bjornpo/ESP32_SensorScope/README.md

# ESP32_SensorScope
A protocol analyzer and simulator for serial sensors

## Initializing Submodules
This project uses Git submodules for kicad part library. To clone the repository and initialize submodules:
```bash
git clone --recurse-submodules <repo-url>
