bjornpo/ESP32_SensorScope/hardware/kicad/ESP32_SensorScope/4Inch TFT SPI LCD 480X320.step

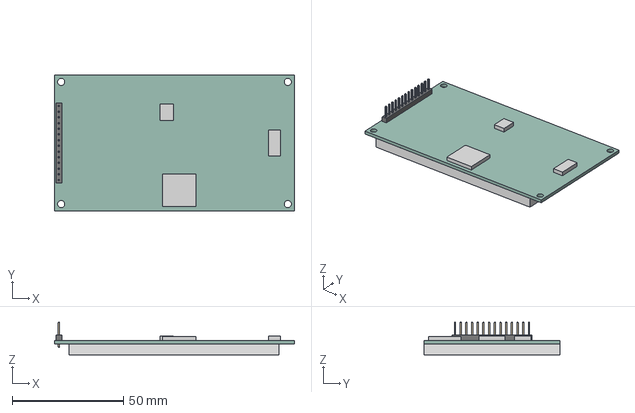
[picture p3: CAD file, 2025-01-19]
hardware/kicad/ESP32_SensorScope/4Inch TFT SPI LCD 480X320.step
108.0 x 61.0 x 14.8 mm
