bjornpo/ESP32_SensorScope/hardware/kicad/ESP32_SensorScope/ESP32-S3-WROOM-1.kicad_sch

## KiCad design hardware/kicad/ESP32_SensorScope/ESP32-S3-WROOM-1.kicad_sch (2025-04-11, an earlier design)

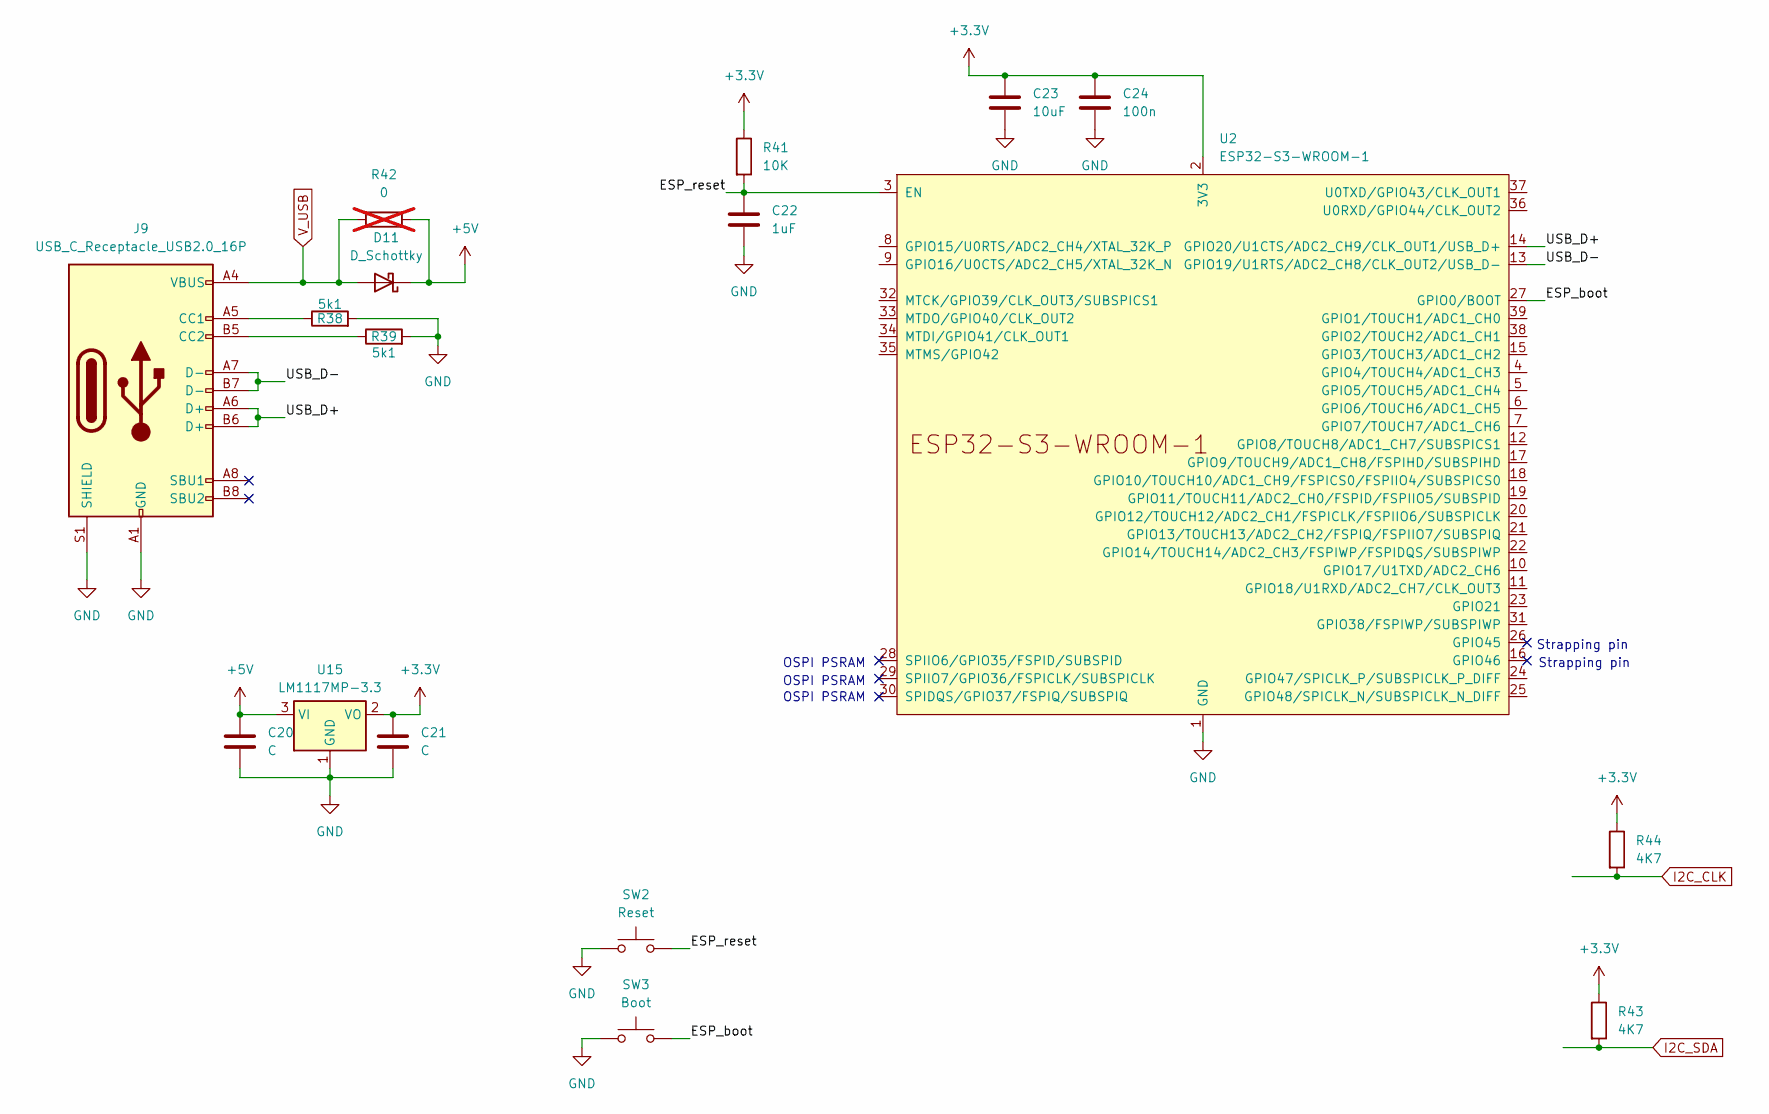
[picture p4: schematic ESP32-S3-WROOM-1.kicad_sch]

Parts:
C20, C21: C
C22: 1uF
C23: 10uF
C24: 100n
D11: D_Schottky
J9: USB_C_Receptacle_USB2.0_16P
R38, R39: 5k1
R41: 10K
R42: 0; not fitted
R43, R44: 4K7
SW2: Reset
SW3: Boot
U2: ESP32-S3-WROOM-1
U15: LM1117MP-3.3; SOT-223-3_TabPin2

Connections:
+3.3V: C21.1, C23.1, C24.1, R41.1, R43.1, R44.1, U2.2 (3V3), U15.2 (VO)
+5V: C20.1, D11.1 (K), R42.2, U15.3 (VI)
ESP_boot: SW3.2, U2.27 (GPIO0/BOOT)
ESP_reset: C22.1, R41.2, SW2.2, U2.3 (EN)
GND: C20.2, C21.2, C22.2, C23.2, C24.2, J9.A1 (GND), J9.A12 (GND), J9.B1 (GND), J9.B12 (GND), J9.S1 (SHIELD), R38.2, R39.2, SW2.1, SW3.1, U2.1 (GND), U2.40 (GND), U2.41 (GND), U15.1 (GND)
I2C_CLK: R44.2
I2C_SDA: R43.2
unnamed: J9.A5 (CC1), R38.1
unnamed: J9.B5 (CC2), R39.1
USB_D+: J9.A6 (D+), J9.B6 (D+), U2.14 (GPIO20/U1CTS/ADC2_CH9/CLK_OUT1/USB_D+)
USB_D-: J9.A7 (D-), J9.B7 (D-), U2.13 (GPIO19/U1RTS/ADC2_CH8/CLK_OUT2/USB_D-)
V_USB: D11.2 (A), J9.A4 (VBUS), J9.A9 (VBUS), J9.B4 (VBUS), J9.B9 (VBUS), R42.1

Notes on the sheet:
Strapping pin
OSPI PSRAM
