bjornpo/ESP32_SensorScope/hardware/kicad/ESP32_SensorScope/Power_management.kicad_sch

## KiCad design hardware/kicad/ESP32_SensorScope/Power_management.kicad_sch (2025-04-11, an earlier design)

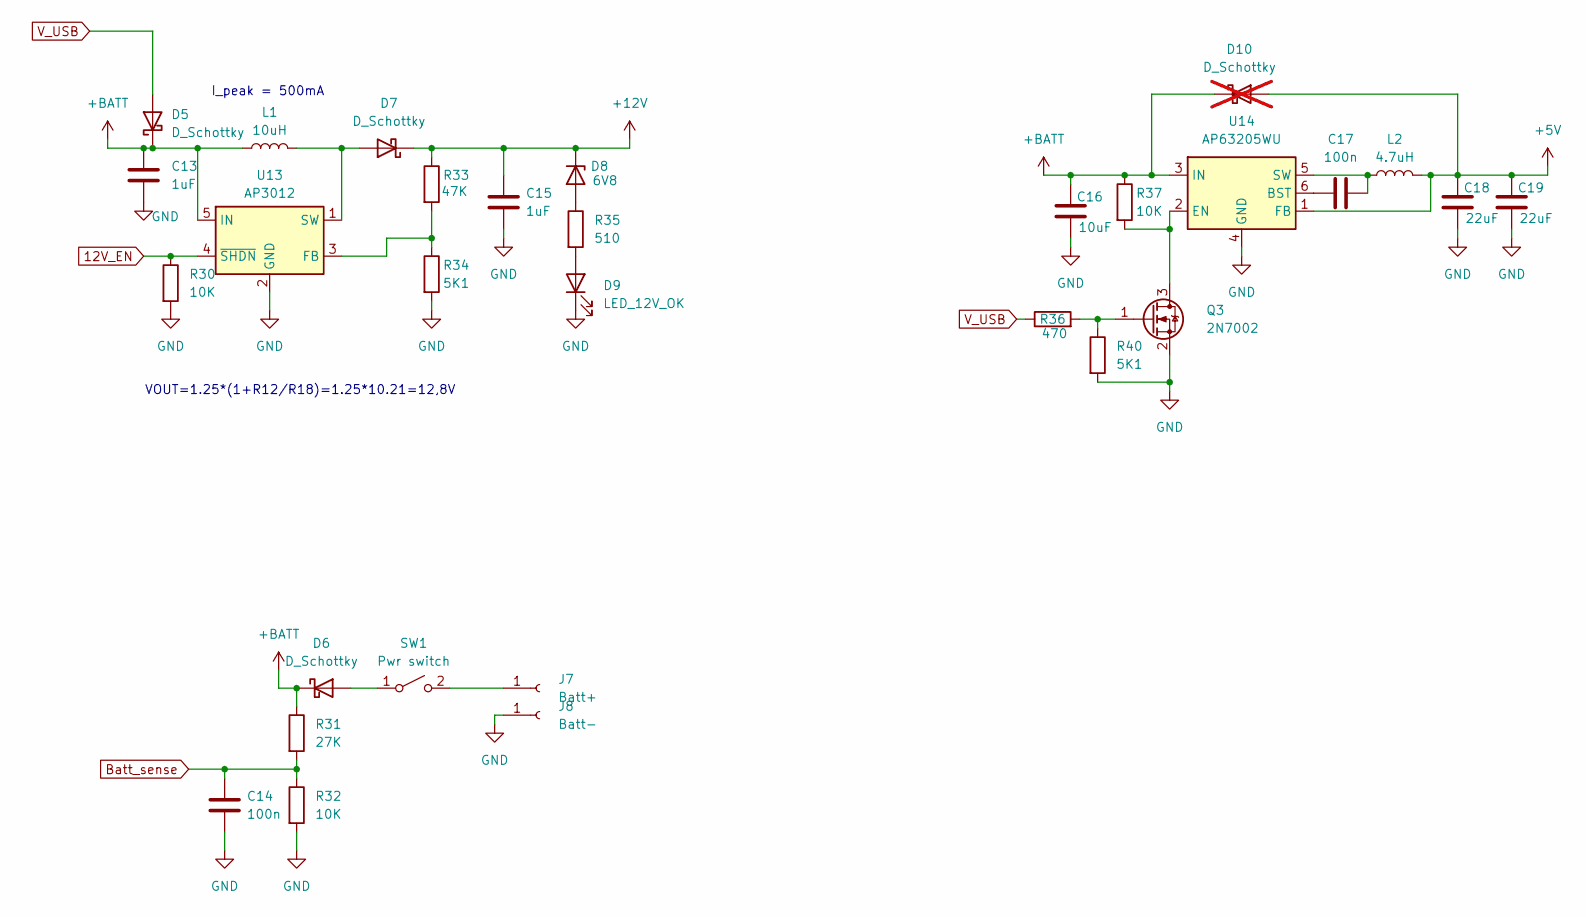
[picture p5: schematic Power_management.kicad_sch]

Parts:
C13, C15: 1uF
C14, C17: 100n
C16: 10uF
C18, C19: 22uF
D5, D6, D7: D_Schottky
D8: 6V8
D9: LED_12V_OK
D10: D_Schottky; not fitted
J7: Batt+
J8: Batt-
L1: 10uH
L2: 4.7uH
Q3: 2N7002; SOT-23
R30, R32, R37: 10K
R31: 27K
R33: 47K
R34, R40: 5K1
R35: 510
R36: 470
SW1: Pwr switch
U13: AP3012; SOT-23-5
U14: AP63205WU; TSOT-23-6

Connections:
12V_EN: R30.1, U13.4 (~SHDN)
+5V: C18.2, C19.2, D10.2 (A), L2.2, U14.1 (FB)
+12V: C15.1, D7.1 (K), D8.1 (K), R33.1
+BATT: C13.1, C16.2, D5.1 (K), D6.1 (K), D10.1 (K), L1.1, R31.1, R37.1, U13.5 (IN), U14.3 (IN)
Batt_sense: C14.1, R31.2, R32.1
GND: C13.2, C14.2, C15.2, C16.1, C18.1, C19.1, D9.1 (K), J8.1, Q3.2 (S), R30.2, R32.2, R34.2, R40.2, U13.2 (GND), U14.4 (GND)
unnamed: C17.1, U14.6 (BST)
unnamed: C17.2, L2.1, U14.5 (SW)
unnamed: D6.2 (A), SW1.1 (A)
unnamed: D7.2 (A), L1.2, U13.1 (SW)
unnamed: D8.2 (A), R35.1
unnamed: D9.2 (A), R35.2
unnamed: J7.1, SW1.2 (B)
unnamed: Q3.1 (G), R36.2, R40.1
unnamed: Q3.3 (D), R37.2, U14.2 (EN)
unnamed: R33.2, R34.1, U13.3 (FB)
V_USB: D5.2 (A), R36.1

Notes on the sheet:
I_peak = 500mA
VOUT=1.25*(1+R12/R18)=1.25*10.21=12,8V
