bjornpo/ESP32_SensorScope/hardware/kicad/ESP32_SensorScope/RS232.kicad_sch

## KiCad design hardware/kicad/ESP32_SensorScope/RS232.kicad_sch (2025-04-11, an earlier design)

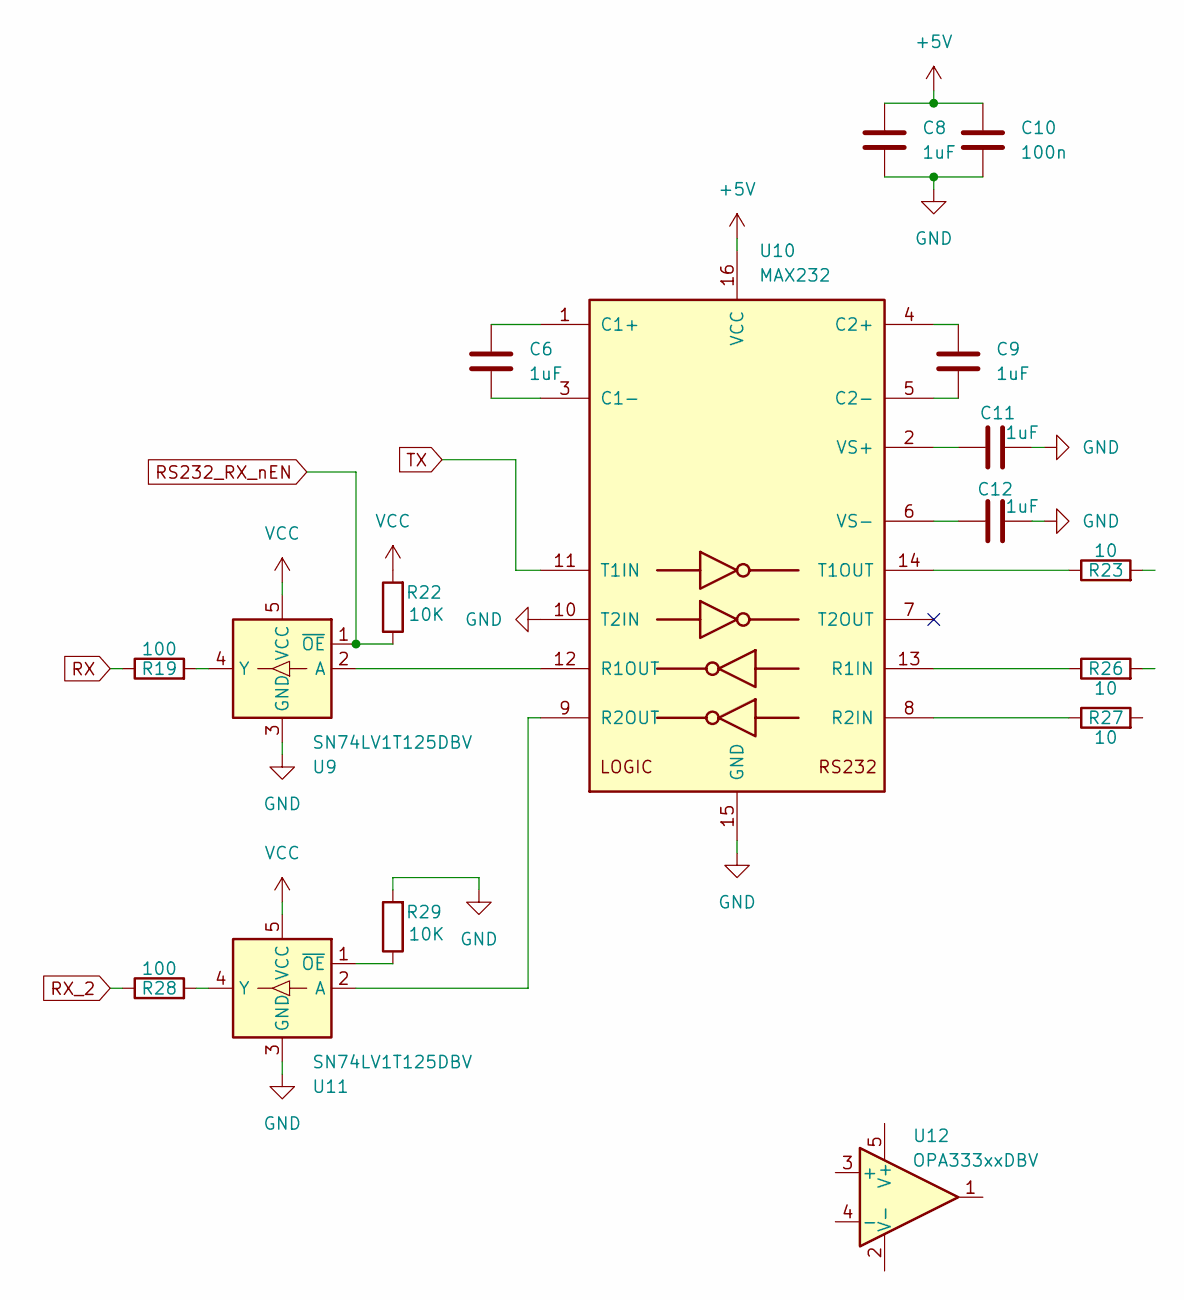
[picture p6: schematic RS232.kicad_sch]

Parts:
C6, C8, C9, C11, C12: 1uF
C10: 100n
R19, R28: 100
R22, R29: 10K
R23, R26, R27: 10
U9, U11: SN74LV1T125DBV; SOT-23-5
U10: MAX232
U12: OPA333xxDBV; SOT-23-5

Connections:
+5V: C8.1, C10.1, U10.16 (VCC)
GND: C8.2, C10.2, C11.1, C12.1, R29.2, U9.3 (GND), U10.10 (T2IN), U10.15 (GND), U11.3 (GND)
unnamed: C6.1, U10.1 (C1+)
unnamed: C6.2, U10.3 (C1-)
unnamed: C9.1, U10.4 (C2+)
unnamed: C9.2, U10.5 (C2-)
unnamed: C11.2, U10.2 (VS+)
unnamed: C12.2, U10.6 (VS-)
unnamed: R19.2, U9.4 (Y)
unnamed: R23.1, U10.14 (T1OUT)
unnamed: R26.1, U10.13 (R1IN)
unnamed: R27.1, U10.8 (R2IN)
unnamed: R28.2, U11.4 (Y)
unnamed: R29.1, U11.1 (~OE)
unnamed: U10.9 (R2OUT), U11.2 (A)
unnamed: U9.2 (A), U10.12 (R1OUT)
RS232_RX_nEN: R22.1, U9.1 (~OE)
RX: R19.1
RX_2: R28.1
TX: U10.11 (T1IN)
VCC: R22.2, U9.5 (VCC), U11.5 (VCC)
