bjornpo/ESP32_SensorScope/hardware/kicad/ESP32_SensorScope/RS485.kicad_sch

## KiCad design hardware/kicad/ESP32_SensorScope/RS485.kicad_sch (2025-04-11, an earlier design)

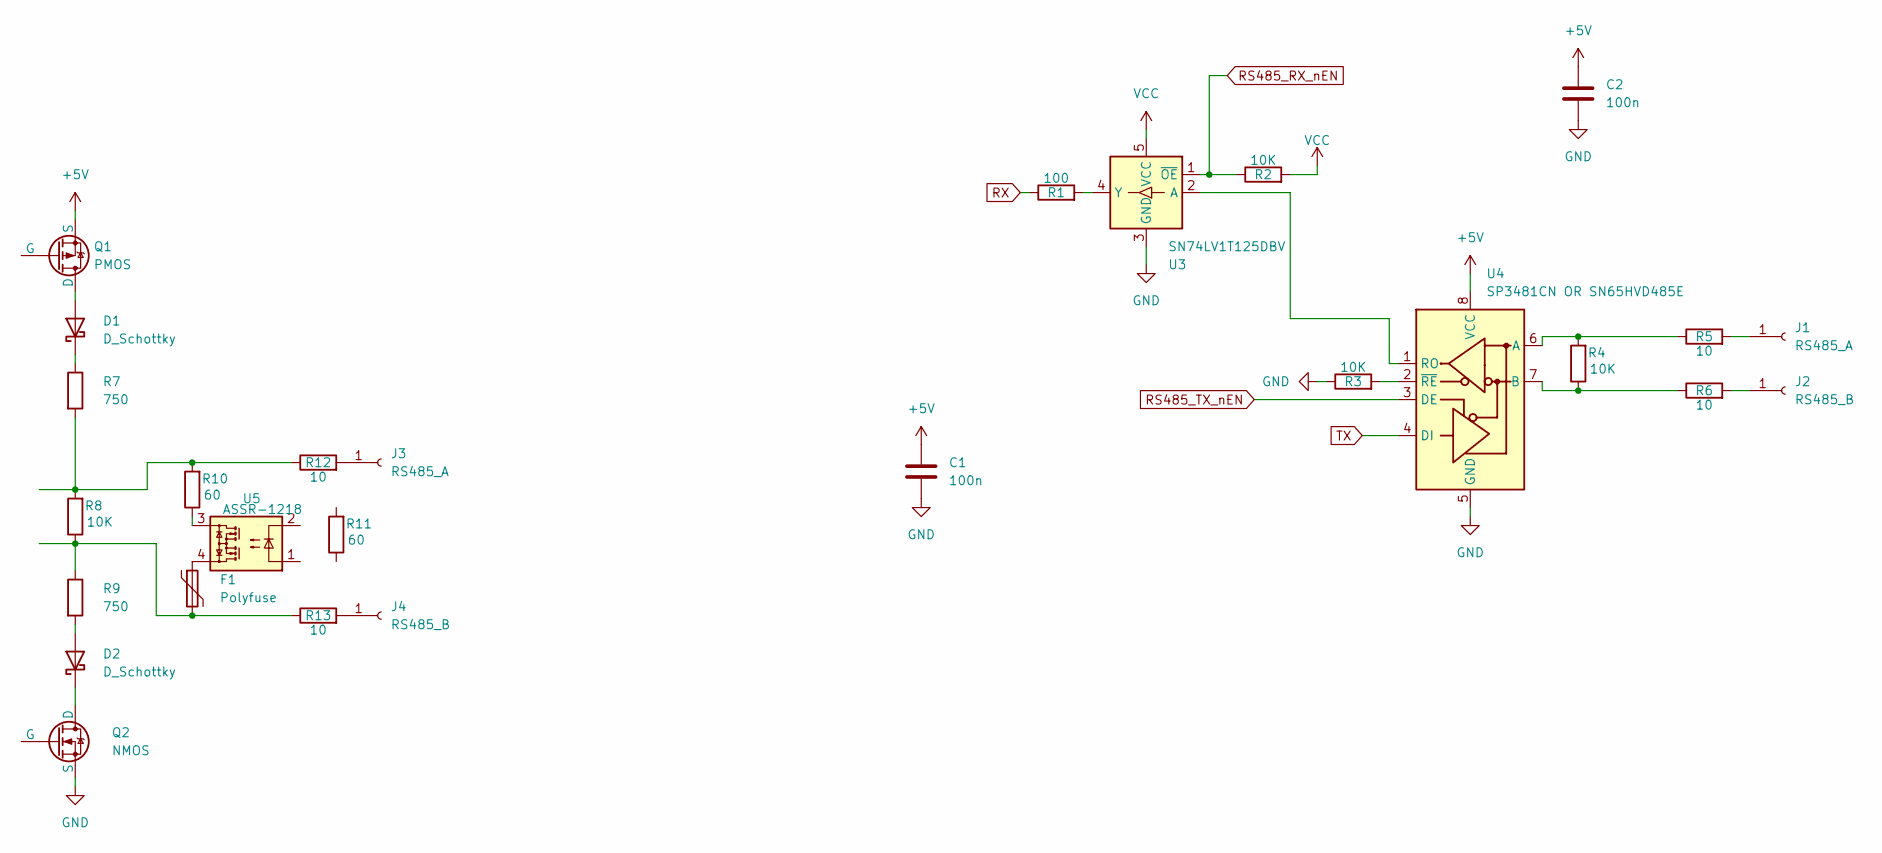
[picture p7: schematic RS485.kicad_sch]

Parts:
C1, C2: 100n
D1, D2: D_Schottky
F1: Polyfuse
J1, J3: RS485_A
J2, J4: RS485_B
Q1: PMOS
Q2: NMOS
R1: 100
R2, R3, R4, R8: 10K
R5, R6, R12, R13: 10
R7, R9: 750
R10, R11: 60
U3: SN74LV1T125DBV; SOT-23-5
U4: SP3481CN OR SN65HVD485E; SOIC-8_3.9x4.9mm_P1.27mm
U5: ASSR-1218; SO-4_4.4x4.3mm_P2.54mm

Connections:
+5V: C1.1, C2.1, Q1.3 (S), U4.8 (VCC)
GND: C1.2, C2.2, Q2.3 (S), R3.1, U3.3 (GND), U4.5 (GND)
unnamed: D1.1 (K), R7.1
unnamed: D1.2 (A), Q1.1 (D)
unnamed: D2.1 (K), Q2.1 (D)
unnamed: D2.2 (A), R9.2
unnamed: F1.1, U5.4
unnamed: F1.2, R8.1, R9.1, R13.1
unnamed: J1.1, R5.2
unnamed: J2.1, R6.2
unnamed: J3.1, R12.2
unnamed: J4.1, R13.2
unnamed: R1.2, U3.4 (Y)
unnamed: R3.2, U4.2 (~RE)
unnamed: R4.1, R6.1, U4.7 (B)
unnamed: R4.2, R5.1, U4.6 (A)
unnamed: R10.1, U5.3
unnamed: R7.2, R8.2, R10.2, R12.1
unnamed: U3.2 (A), U4.1 (RO)
RS485_RX_nEN: R2.1, U3.1 (~OE)
RS485_TX_nEN: U4.3 (DE)
RX: R1.1
TX: U4.4 (DI)
VCC: R2.2, U3.5 (VCC)
