bjornpo/ESP32_SensorScope/hardware/kicad/ESP32_SensorScope/SDI12.kicad_sch

## KiCad design hardware/kicad/ESP32_SensorScope/SDI12.kicad_sch (2025-04-11, an earlier design)

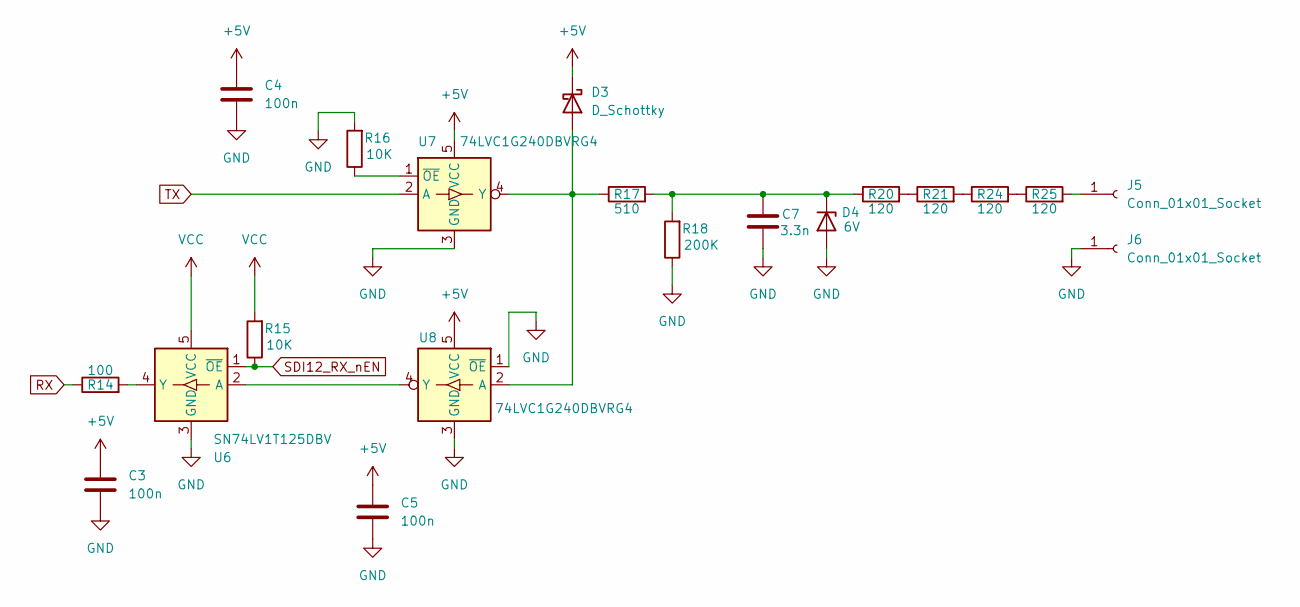
[picture p8: schematic SDI12.kicad_sch]

Parts:
C3, C4, C5: 100n
C7: 3.3n
D3: D_Schottky
D4: 6V
J5, J6: Conn_01x01_Socket
R14: 100
R15, R16: 10K
R17: 510
R18: 200K
R20, R21, R24, R25: 120
U6: SN74LV1T125DBV; SOT-23-5
U7, U8: 74LVC1G240DBVRG4; SOT-23-5

Connections:
+5V: C3.1, C4.1, C5.1, D3.1 (K), U7.5 (VCC), U8.5 (VCC)
GND: C3.2, C4.2, C5.2, C7.2, D4.2 (A), J6.1, R16.2, R18.1, U6.3 (GND), U7.3 (GND), U8.1 (~OE), U8.3 (GND)
unnamed: C7.1, D4.1 (K), R17.2, R18.2, R20.1
unnamed: D3.2 (A), R17.1, U7.4 (Y), U8.2 (A)
unnamed: J5.1, R25.2
unnamed: R14.2, U6.4 (Y)
unnamed: R16.1, U7.1 (~OE)
unnamed: R20.2, R21.1
unnamed: R21.2, R24.1
unnamed: R24.2, R25.1
unnamed: U6.2 (A), U8.4 (Y)
RX: R14.1
SDI12_RX_nEN: R15.1, U6.1 (~OE)
TX: U7.2 (A)
VCC: R15.2, U6.5 (VCC)
