bjornpo/ESP32_SensorScope/hardware/kicad/ESP32_SensorScope/Scope.kicad_sch

## KiCad design hardware/kicad/ESP32_SensorScope/Scope.kicad_sch (2025-04-11, an earlier design)

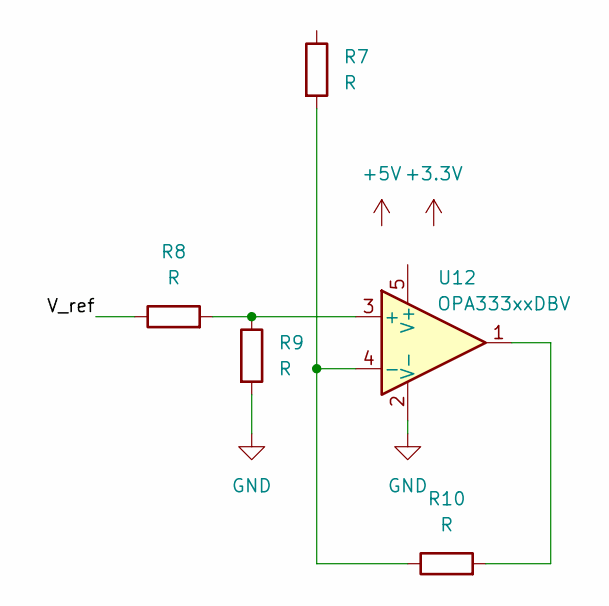
[picture p9: schematic Scope.kicad_sch]

Parts:
R7, R8, R9, R10: R
U12: OPA333xxDBV; SOT-23-5

Connections:
GND: R9.2, U12.2 (V-)
unnamed: R8.2, R9.1, U12.3 (+)
unnamed: R7.2, R10.1, U12.4 (-)
unnamed: R10.2, U12.1
V_ref: R8.1
