bjornpo/ESP32_SensorScope/hardware/kicad/ESP32_SensorScope/UART.kicad_sch

## KiCad design hardware/kicad/ESP32_SensorScope/UART.kicad_sch (2025-04-11, an earlier design)

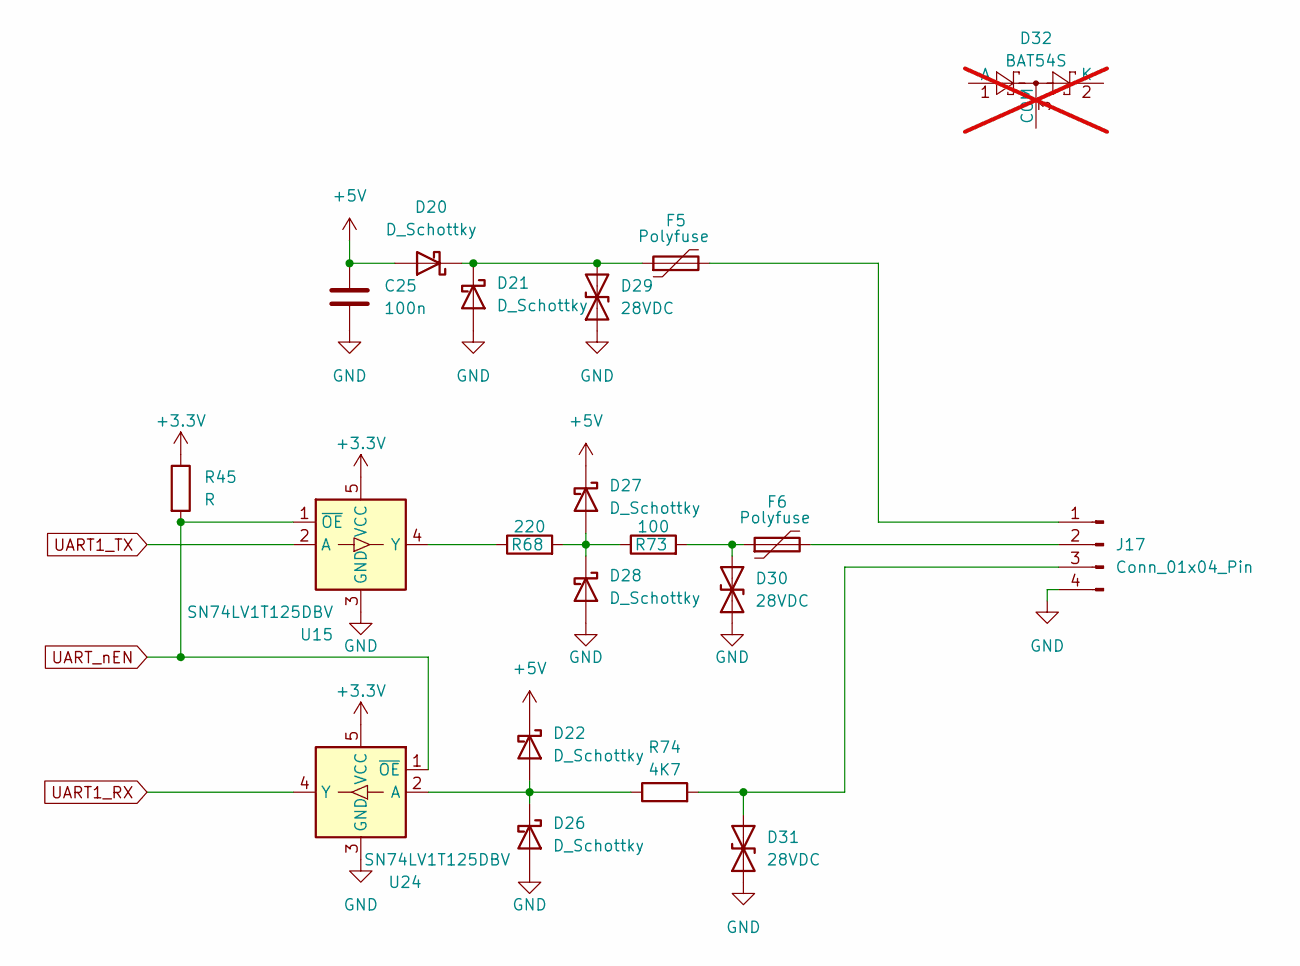
[picture p10: schematic UART.kicad_sch]

Parts:
C25: 100n
D20, D21, D22, D26, D27, D28: D_Schottky
D29, D30, D31: 28VDC
D32: BAT54S; SOT-23; not fitted
F5, F6: Polyfuse
J17: Conn_01x04_Pin
R45: R
R68: 220
R73: 100
R74: 4K7
U15, U24: SN74LV1T125DBV; SOT-23-5

Connections:
+3.3V: R45.1, U15.5 (VCC), U24.5 (VCC)
+5V: C25.1, D20.2 (A), D22.1 (K), D27.1 (K)
GND: C25.2, D21.2 (A), D26.2 (A), D28.2 (A), D29.1 (A1), D30.1 (A1), D31.1 (A1), J17.4, U15.3 (GND), U24.3 (GND)
unnamed: D20.1 (K), D21.1 (K), D29.2 (A2), F5.1
unnamed: D22.2 (A), D26.1 (K), R74.1, U24.2 (A)
unnamed: D27.2 (A), D28.1 (K), R68.2, R73.1
unnamed: D30.2 (A2), F6.1, R73.2
unnamed: D31.2 (A2), J17.3, R74.2
unnamed: F5.2, J17.1
unnamed: F6.2, J17.2
unnamed: R68.1, U15.4 (Y)
UART1_RX: U24.4 (Y)
UART1_TX: U15.2 (A)
UART_nEN: R45.2, U15.1 (~OE), U24.1 (~OE)
