bjornpo/ESP32_SensorScope/firmware/ESP32_SensorScope_IDF/main/display_driver.c

// display_driver.c
#include "display_driver.h"
#include "esp_log.h"
#include "driver/gpio.h"
#include "driver/spi_master.h"
#include "driver/i2c_master.h"
#include "esp_timer.h"
#include "esp_heap_caps.h"
#include "esp_lcd_st7796.h"
#include <sys/lock.h>
#include <unistd.h>
#include <sys/param.h>
#include "esp_lcd_panel_ops.h"

#define LCD_HOST SPI2_HOST
#define EXAMPLE_LCD_PIXEL_CLOCK_HZ (80 * 1000 * 1000)
#define TASK_CPU_CORE 0 // CPU core for LVGL task (0 or 1)

#define EXAMPLE_PIN_NUM_SCLK 12
#define EXAMPLE_PIN_NUM_MOSI 11
#define EXAMPLE_PIN_NUM_MISO 13
#define EXAMPLE_PIN_NUM_LCD_DC 14
#define EXAMPLE_PIN_NUM_LCD_RST 39
#define EXAMPLE_PIN_NUM_LCD_CS 10
#define EXAMPLE_PIN_NUM_BK_LIGHT 40
#define EXAMPLE_LCD_H_RES 320
#define EXAMPLE_LCD_V_RES 480
#define EXAMPLE_LVGL_DRAW_BUF_LINES 80 // number of display lines in each draw buffer
#define EXAMPLE_LVGL_TICK_PERIOD_MS 2
#define EXAMPLE_LVGL_TASK_STACK_SIZE (6 * 1024)
#define EXAMPLE_LVGL_TASK_PRIORITY 2

#define EXAMPLE_I2C_TOUCH_CLOCK_HZ 100000
#define EXAMPLE_PIN_SCL 9
#define EXAMPLE_PIN_SDA 8

static const char *TAG = "display_driver";
static _lock_t lvgl_api_lock;

void lvgl_lock(void) {
    _lock_acquire(&lvgl_api_lock);
}

void lvgl_unlock(void) {
    _lock_release(&lvgl_api_lock);
}

static bool example_notify_lvgl_flush_ready(esp_lcd_panel_io_handle_t panel_io, esp_lcd_panel_io_event_data_t *edata, void *user_ctx)
{
    lv_display_t *disp = (lv_display_t *)user_ctx;
    lv_display_flush_ready(disp);
    return false;
}

/* Rotate display and touch, when rotated screen in LVGL. Called when driver parameters are updated. */
static void example_lvgl_port_update_callback(lv_display_t *disp)
{
    esp_lcd_panel_handle_t panel_handle = lv_display_get_user_data(disp);
    lv_display_rotation_t rotation = lv_display_get_rotation(disp);

    switch (rotation) {
    case LV_DISPLAY_ROTATION_0:
        // Rotate LCD display
        esp_lcd_panel_swap_xy(panel_handle, false);
        esp_lcd_panel_mirror(panel_handle, true, false);
        break;
    case LV_DISPLAY_ROTATION_90:
        // Rotate LCD display
        esp_lcd_panel_swap_xy(panel_handle, true);
        esp_lcd_panel_mirror(panel_handle, true, true);
        break;
    case LV_DISPLAY_ROTATION_180:
        // Rotate LCD display
        esp_lcd_panel_swap_xy(panel_handle, false);
        esp_lcd_panel_mirror(panel_handle, false, true);
        break;
    case LV_DISPLAY_ROTATION_270:
        // Rotate LCD display
        esp_lcd_panel_swap_xy(panel_handle, true);
        esp_lcd_panel_mirror(panel_handle, false, false);
        break;
    }
}

static void example_lvgl_flush_cb(lv_display_t *disp, const lv_area_t *area, uint8_t *px_map)
{
    //example_lvgl_port_update_callback(disp);
    esp_lcd_panel_handle_t panel_handle = lv_display_get_user_data(disp);
    int offsetx1 = area->x1;
    int offsetx2 = area->x2;
    int offsety1 = area->y1;
    int offsety2 = area->y2;
    // because SPI LCD is big-endian, we need to swap the RGB bytes order
    lv_draw_sw_rgb565_swap(px_map, (offsetx2 + 1 - offsetx1) * (offsety2 + 1 - offsety1));
    // copy a buffer's content to a specific area of the display
    esp_lcd_panel_draw_bitmap(panel_handle, offsetx1, offsety1, offsetx2 + 1, offsety2 + 1, px_map);
}

static void example_lvgl_touch_cb(lv_indev_t * indev, lv_indev_data_t * data)
{   
    uint16_t touchpad_x[1] = {0};
    uint16_t touchpad_y[1] = {0};
    uint8_t touchpad_cnt = 0;

    esp_lcd_touch_handle_t touch_pad = lv_indev_get_user_data(indev);
    esp_lcd_touch_read_data(touch_pad);
    /* Get coordinates */
    bool touchpad_pressed = esp_lcd_touch_get_coordinates(touch_pad, touchpad_x, touchpad_y, NULL, &touchpad_cnt, 1);

    if (touchpad_pressed && touchpad_cnt > 0) {
        data->point.x = touchpad_x[0];
        data->point.y = touchpad_y[0];
        data->state = LV_INDEV_STATE_PRESSED;
    } else {
        data->state = LV_INDEV_STATE_RELEASED;
    }
}

static void example_increase_lvgl_tick(void *arg)
{
    /* Tell LVGL how many milliseconds has elapsed */
    lv_tick_inc(EXAMPLE_LVGL_TICK_PERIOD_MS);
}

static void example_lvgl_port_task(void *arg)
{
    ESP_LOGI(TAG, "Starting LVGL task");
    uint32_t time_till_next_ms = 0;
    uint32_t time_threshold_ms = 1000 / CONFIG_FREERTOS_HZ;
    while (1) {
        _lock_acquire(&lvgl_api_lock);
        //lvgl_lock();
        time_till_next_ms = lv_timer_handler();
        _lock_release(&lvgl_api_lock);
        //lvgl_unlock();
        // in case of triggering a task watch dog time out
        time_till_next_ms = MAX(time_till_next_ms, time_threshold_ms);
        //usleep(1000 * time_till_next_ms);
        vTaskDelay(pdMS_TO_TICKS(time_till_next_ms));

        //UBaseType_t watermark = uxTaskGetStackHighWaterMark(NULL);
        //ESP_LOGI("LVGL", "Stack watermark: %u bytes", watermark);
    }
}

void display_driver_init_display(void)
{
    ESP_LOGI(TAG, "Turn off LCD backlight");
    gpio_config_t bk_gpio_config = {
        .mode = GPIO_MODE_OUTPUT,
        .pin_bit_mask = 1ULL << EXAMPLE_PIN_NUM_BK_LIGHT
    };
    ESP_ERROR_CHECK(gpio_config(&bk_gpio_config));

    ESP_LOGI(TAG, "Initialize SPI bus");
    spi_bus_config_t buscfg = {
        .sclk_io_num = EXAMPLE_PIN_NUM_SCLK,
        .mosi_io_num = EXAMPLE_PIN_NUM_MOSI,
        .miso_io_num = EXAMPLE_PIN_NUM_MISO,
        .quadwp_io_num = -1,
        .quadhd_io_num = -1,
        .max_transfer_sz = EXAMPLE_LCD_H_RES * EXAMPLE_LVGL_DRAW_BUF_LINES * sizeof(uint16_t),
    };
    ESP_ERROR_CHECK(spi_bus_initialize(LCD_HOST, &buscfg, SPI_DMA_CH_AUTO));

    ESP_LOGI(TAG, "Initialize I2C bus");
    i2c_master_bus_config_t i2c_config = {
        .i2c_port = -1,
        .sda_io_num = EXAMPLE_PIN_SDA,
        .scl_io_num = EXAMPLE_PIN_SCL,
        .clk_source = I2C_CLK_SRC_DEFAULT,
        .glitch_ignore_cnt = 7,
        .intr_priority = 0,
        //.trans_queue_depth = 0,
        .flags.enable_internal_pullup = true
    };

    i2c_master_bus_handle_t i2c_bus_handle;
    ESP_ERROR_CHECK(i2c_new_master_bus(&i2c_config, &i2c_bus_handle));

    ESP_LOGI(TAG, "Install panel IO");
    esp_lcd_panel_io_handle_t io_handle = NULL;
    esp_lcd_panel_io_spi_config_t io_config = {
        .dc_gpio_num = EXAMPLE_PIN_NUM_LCD_DC,
        .cs_gpio_num = EXAMPLE_PIN_NUM_LCD_CS,
        .pclk_hz = EXAMPLE_LCD_PIXEL_CLOCK_HZ,
        .lcd_cmd_bits = 8,
        .lcd_param_bits = 8,
        .spi_mode = 0,
        .trans_queue_depth = 10,
    };
    // Attach the LCD to the SPI bus
    ESP_ERROR_CHECK(esp_lcd_new_panel_io_spi((esp_lcd_spi_bus_handle_t)LCD_HOST, &io_config, &io_handle));

    esp_lcd_panel_handle_t panel_handle = NULL;
    esp_lcd_panel_dev_config_t panel_config = {
        .reset_gpio_num = EXAMPLE_PIN_NUM_LCD_RST,
        .rgb_ele_order = LCD_RGB_ELEMENT_ORDER_BGR,
        .bits_per_pixel = 16,
    };
    ESP_LOGI(TAG, "Install st7796 panel driver");
    ESP_ERROR_CHECK(esp_lcd_new_panel_st7796(io_handle, &panel_config, &panel_handle));

    ESP_ERROR_CHECK(esp_lcd_panel_reset(panel_handle));
    ESP_ERROR_CHECK(esp_lcd_panel_init(panel_handle));
    ESP_ERROR_CHECK(esp_lcd_panel_mirror(panel_handle, true, false));

    // user can flush pre-defined pattern to the screen before we turn on the screen or backlight
    ESP_ERROR_CHECK(esp_lcd_panel_disp_on_off(panel_handle, true));

    ESP_LOGI(TAG, "Turn on LCD backlight");
    gpio_set_level(EXAMPLE_PIN_NUM_BK_LIGHT, 1);

    vTaskDelay(10 / portTICK_PERIOD_MS);
    ESP_LOGI(TAG, "Initialize LVGL library");
    lv_init();

    // create a lvgl display
    lv_display_t *display = lv_display_create(EXAMPLE_LCD_H_RES, EXAMPLE_LCD_V_RES);

    // alloc draw buffers used by LVGL
    // it's recommended to choose the size of the draw buffer(s) to be at least 1/10 screen sized
    size_t draw_buffer_sz = EXAMPLE_LCD_H_RES * EXAMPLE_LVGL_DRAW_BUF_LINES * sizeof(lv_color16_t);

    //Plase framebuffer in external PSRAM 
    void *buf1 = heap_caps_malloc(draw_buffer_sz, MALLOC_CAP_SPIRAM);
    void *buf2 = heap_caps_malloc(draw_buffer_sz, MALLOC_CAP_SPIRAM);

    //void *buf1 = spi_bus_dma_memory_alloc(LCD_HOST, draw_buffer_sz, 0);
    assert(buf1);
    //void *buf2 = spi_bus_dma_memory_alloc(LCD_HOST, draw_buffer_sz, 0);
    assert(buf2);
    // check if buffers are PSRAM
    ESP_LOGI(TAG, "Buffer 1: %s", esp_ptr_external_ram(buf1) ? "PSRAM" : "DRAM");
    ESP_LOGI(TAG, "Buffer 2: %s", esp_ptr_external_ram(buf2) ? "PSRAM" : "DRAM");
    // initialize LVGL draw buffers
    lv_display_set_buffers(display, buf1, buf2, draw_buffer_sz, LV_DISPLAY_RENDER_MODE_PARTIAL);
    //lv_display_set_buffers(display, buf1, NULL, draw_buffer_sz, LV_DISPLAY_RENDER_MODE_PARTIAL);
    // associate the mipi panel handle to the display
    lv_display_set_user_data(display, panel_handle);
    // BPO rotate display
    lv_display_set_rotation(display, LV_DISPLAY_ROTATION_270);
    // set color depth
    lv_display_set_color_format(display, LV_COLOR_FORMAT_RGB565);
    // set the callback which can copy the rendered image to an area of the display
    lv_display_set_flush_cb(display, example_lvgl_flush_cb);

    //TODO: improve used to run at every draw
    example_lvgl_port_update_callback(display);

    ESP_LOGI(TAG, "Install LVGL tick timer");
    // Tick interface for LVGL (using esp_timer to generate 2ms periodic event)
    const esp_timer_create_args_t lvgl_tick_timer_args = {
        .callback = &example_increase_lvgl_tick,
        .name = "lvgl_tick"
    };
    esp_timer_handle_t lvgl_tick_timer = NULL;
    ESP_ERROR_CHECK(esp_timer_create(&lvgl_tick_timer_args, &lvgl_tick_timer));
    ESP_ERROR_CHECK(esp_timer_start_periodic(lvgl_tick_timer, EXAMPLE_LVGL_TICK_PERIOD_MS * 1000));

    ESP_LOGI(TAG, "Register io panel event callback for LVGL flush ready notification");
    const esp_lcd_panel_io_callbacks_t cbs = {
        .on_color_trans_done = example_notify_lvgl_flush_ready,
    };
    /* Register done callback */
    ESP_ERROR_CHECK(esp_lcd_panel_io_register_event_callbacks(io_handle, &cbs, display));


    ESP_LOGI(TAG, "Initialize touch controller FT5x06, speed=%d HZ", EXAMPLE_I2C_TOUCH_CLOCK_HZ);
    esp_lcd_panel_io_handle_t tp_io_handle = NULL;
    //esp_lcd_panel_io_spi_config_t tp_io_config = ESP_LCD_TOUCH_IO_SPI_STMPE610_CONFIG(EXAMPLE_PIN_NUM_TOUCH_CS);
    esp_lcd_panel_io_i2c_config_t tp_io_config = ESP_LCD_TOUCH_IO_I2C_FT5x06_CONFIG();
    tp_io_config.scl_speed_hz = EXAMPLE_I2C_TOUCH_CLOCK_HZ;//100000; // force I2C speet
    // Attach the TOUCH to the SPI bus
    ESP_ERROR_CHECK(esp_lcd_new_panel_io_i2c(i2c_bus_handle, &tp_io_config, &tp_io_handle));
    //ESP_ERROR_CHECK(esp_lcd_new_panel_io_spi((esp_lcd_spi_bus_handle_t)LCD_HOST, &tp_io_config, &tp_io_handle));

    esp_lcd_touch_config_t tp_cfg = {
        .x_max = EXAMPLE_LCD_H_RES,
        .y_max = EXAMPLE_LCD_V_RES,
        .rst_gpio_num = -1,
        .int_gpio_num = -1,
        .levels = {
            .reset = 0,
            .interrupt = 0,
        },
        .flags = {
            .swap_xy = 0,
            .mirror_x = 0,
            .mirror_y = 0,
        },
    };
    esp_lcd_touch_handle_t tp = NULL;

    ESP_ERROR_CHECK(esp_lcd_touch_new_i2c_ft5x06(tp_io_handle, &tp_cfg, &tp));

    static lv_indev_t *indev;
    indev = lv_indev_create();  // Input device driver (Touch)
    lv_indev_set_type(indev, LV_INDEV_TYPE_POINTER);
    lv_indev_set_display(indev, display);
    lv_indev_set_user_data(indev, tp);
    lv_indev_set_read_cb(indev, example_lvgl_touch_cb);

    ESP_LOGI(TAG, "Create LVGL task");
    xTaskCreatePinnedToCore(example_lvgl_port_task, "LVGL", EXAMPLE_LVGL_TASK_STACK_SIZE, NULL, EXAMPLE_LVGL_TASK_PRIORITY, NULL, TASK_CPU_CORE);

}
