bjornpo/ESP32_SensorScope/firmware/ESP32_SensorScope_IDF/main/settings.h

#pragma once
#include "serial_analyzer.h"
#include "oscilloscope_ui.h"

typedef struct {
    uint32_t version;
    SerialAnalyzerConfig serial_analyzer;
    Oscilloscope_config_t oscilloscope;
    //ModbusConfig modbus;
    //SDI12Config sdi12;
} AppSettings;

void nvs_init(void);
void nvs_save_settings();
void init_default_settings(AppSettings *cfg);

extern AppSettings g_settings;
