bjornpo/ESP32_SensorScope/firmware/ESP32_SensorScope_IDF/lv_ui_code/Greek_alphabet_14.c

/*******************************************************************************
 * Size: 14 px
 * Bpp: 4
 * Opts: --bpp 4 --size 14 --no-compress --font Montserrat-Regular.ttf --symbols α β γ δ ε ζ η θ ι κ λ μ ν ξ ο π ρ σ τ υ φ χ ψ ω Α Β Γ Δ Ε Ζ Η Θ Ι Κ Λ Μ Ν Ξ Ο Π Ρ Σ Τ Υ Φ Χ Ψ Ω --format lvgl -o Greek_alphabet_14.c
 ******************************************************************************/

#ifdef LV_LVGL_H_INCLUDE_SIMPLE
#include "lvgl.h"
#else
#include "lvgl/lvgl.h"
#endif

#ifndef GREEK_ALPHABET_14
#define GREEK_ALPHABET_14 1
#endif

#if GREEK_ALPHABET_14

/*-----------------
 *    BITMAPS
 *----------------*/

/*Store the image of the glyphs*/
static LV_ATTRIBUTE_LARGE_CONST const uint8_t glyph_bitmap[] = {
    /* U+0020 " " */

    /* U+0394 "Δ" */
    0x0, 0x0, 0xbc, 0x0, 0x0, 0x0, 0x0, 0x3c,
    0xb4, 0x0, 0x0, 0x0, 0xb, 0x44, 0xc0, 0x0,
    0x0, 0x3, 0xc0, 0xc, 0x40, 0x0, 0x0, 0xb4,
    0x0, 0x4c, 0x0, 0x0, 0x3c, 0x0, 0x0, 0xc4,
    0x0, 0xb, 0x50, 0x0, 0x4, 0xc0, 0x3, 0xd0,
    0x0, 0x0, 0xc, 0x40, 0xbf, 0xdd, 0xdd, 0xdd,
    0xec, 0x0,

    /* U+039B "Λ" */
    0x0, 0x0, 0xda, 0x0, 0x0, 0x0, 0x5, 0xbe,
    0x20, 0x0, 0x0, 0xd, 0x38, 0x90, 0x0, 0x0,
    0x5b, 0x1, 0xe1, 0x0, 0x0, 0xc4, 0x0, 0x89,
    0x0, 0x4, 0xc0, 0x0, 0x1e, 0x10, 0xc, 0x40,
    0x0, 0x9, 0x80, 0x3c, 0x0, 0x0, 0x2, 0xe1,
    0xb5, 0x0, 0x0, 0x0, 0xa8,

    /* U+03A7 "Χ" */
    0x3c, 0xd4, 0x0, 0x0, 0x7a, 0x0, 0x0, 0x2e,
    0x0, 0x1, 0xe1, 0x0, 0x0, 0x8, 0x80, 0xb,
    0x50, 0x0, 0x0, 0x0, 0xe1, 0x5b, 0x0, 0x0,
    0x0, 0x0, 0x6a, 0xd2, 0x0, 0x0, 0x0, 0x0,
    0xe, 0x80, 0x0, 0x0, 0x0, 0x0, 0x3e, 0xb0,
    0x0, 0x0, 0x0, 0x0, 0xd3, 0xb4, 0x0, 0x0,
    0x0, 0x7, 0x90, 0x3d, 0x0, 0x0, 0x0, 0x1e,
    0x10, 0xa, 0x60, 0x0, 0x0, 0xa6, 0x0, 0x2,
    0xd0, 0x10, 0x4, 0xc0, 0x0, 0x0, 0x6d, 0xc2,

    /* U+03A9 "Ω" */
    0x0, 0x18, 0xde, 0xec, 0x60, 0x0, 0x2, 0xd8,
    0x10, 0x2, 0xac, 0x0, 0xc, 0x70, 0x0, 0x0,
    0xa, 0x80, 0x2e, 0x0, 0x0, 0x0, 0x2, 0xe0,
    0x3d, 0x0, 0x0, 0x0, 0x0, 0xf0, 0x1f, 0x0,
    0x0, 0x0, 0x2, 0xe0, 0xb, 0x60, 0x0, 0x0,
    0xa, 0x70, 0x1, 0xc5, 0x0, 0x0, 0x8b, 0x0,
    0xce, 0xef, 0x60, 0x9, 0xfe, 0xe9,

    /* U+03BB "λ" */
    0x3d, 0xda, 0x0, 0x0, 0x0, 0x10, 0x79, 0x0,
    0x0, 0x0, 0x0, 0xe1, 0x0, 0x0, 0x0, 0xe,
    0x80, 0x0, 0x0, 0x6, 0x9e, 0x10, 0x0, 0x0,
    0xd1, 0x87, 0x0, 0x0, 0x5a, 0x1, 0xe0, 0x0,
    0xc, 0x20, 0xa, 0x60, 0x4, 0xb0, 0x0, 0x2d,
    0x0, 0xc3, 0x0, 0x0, 0xb5,

    /* U+03BC "μ" */
    0x96, 0x0, 0x0, 0xe1, 0x96, 0x0, 0x0, 0xe1,
    0x96, 0x0, 0x0, 0xe1, 0x96, 0x0, 0x0, 0xe1,
    0x97, 0x0, 0x0, 0xf1, 0x9d, 0x10, 0x9, 0xf1,
    0x99, 0xcd, 0xd5, 0xd1, 0x96, 0x0, 0x0, 0x0,
    0x96, 0x0, 0x0, 0x0, 0x96, 0x0, 0x0, 0x0,

    /* U+03C0 "π" */
    0x5, 0xba, 0xeb, 0xab, 0xea, 0xa0, 0xe0, 0xd,
    0x20, 0x3c, 0x0, 0xd, 0x0, 0xf0, 0x3, 0xc0,
    0x0, 0x30, 0x1e, 0x0, 0x3c, 0x0, 0x0, 0x3,
    0xc0, 0x3, 0xc0, 0x0, 0x0, 0x5a, 0x0, 0x3c,
    0x0, 0x0, 0x7, 0x90, 0x3, 0xc0, 0x0,

    /* U+03C7 "χ" */
    0x3c, 0xc1, 0x0, 0xd, 0x20, 0x0, 0x5a, 0x0,
    0x78, 0x0, 0x0, 0xb, 0x31, 0xd0, 0x0, 0x0,
    0x3, 0xba, 0x40, 0x0, 0x0, 0x0, 0xab, 0x0,
    0x0, 0x0, 0x0, 0xdc, 0x0, 0x0, 0x0, 0x7,
    0x77, 0x70, 0x0, 0x0, 0x1d, 0x0, 0xd1, 0x0,
    0x0, 0xa5, 0x0, 0x69, 0x0, 0x4, 0xc0, 0x0,
    0xa, 0xc7
};


/*---------------------
 *  GLYPH DESCRIPTION
 *--------------------*/

static const lv_font_fmt_txt_glyph_dsc_t glyph_dsc[] = {
    {.bitmap_index = 0, .adv_w = 0, .box_w = 0, .box_h = 0, .ofs_x = 0, .ofs_y = 0} /* id = 0 reserved */,
    {.bitmap_index = 0, .adv_w = 59, .box_w = 0, .box_h = 0, .ofs_x = 0, .ofs_y = 0},
    {.bitmap_index = 0, .adv_w = 161, .box_w = 11, .box_h = 9, .ofs_x = 0, .ofs_y = 0},
    {.bitmap_index = 50, .adv_w = 156, .box_w = 10, .box_h = 9, .ofs_x = 0, .ofs_y = 0},
    {.bitmap_index = 95, .adv_w = 126, .box_w = 12, .box_h = 12, .ofs_x = -2, .ofs_y = -3},
    {.bitmap_index = 167, .adv_w = 189, .box_w = 12, .box_h = 9, .ofs_x = 0, .ofs_y = 0},
    {.bitmap_index = 221, .adv_w = 121, .box_w = 9, .box_h = 10, .ofs_x = -1, .ofs_y = 0},
    {.bitmap_index = 266, .adv_w = 152, .box_w = 8, .box_h = 10, .ofs_x = 1, .ofs_y = -3},
    {.bitmap_index = 306, .adv_w = 162, .box_w = 11, .box_h = 7, .ofs_x = -1, .ofs_y = 0},
    {.bitmap_index = 345, .adv_w = 120, .box_w = 10, .box_h = 10, .ofs_x = -1, .ofs_y = -3}
};

/*---------------------
 *  CHARACTER MAPPING
 *--------------------*/

static const uint16_t unicode_list_0[] = {
    0x0, 0x374, 0x37b, 0x387, 0x389, 0x39b, 0x39c, 0x3a0,
    0x3a7
};

/*Collect the unicode lists and glyph_id offsets*/
static const lv_font_fmt_txt_cmap_t cmaps[] =
{
    {
        .range_start = 32, .range_length = 936, .glyph_id_start = 1,
        .unicode_list = unicode_list_0, .glyph_id_ofs_list = NULL, .list_length = 9, .type = LV_FONT_FMT_TXT_CMAP_SPARSE_TINY
    }
};



/*--------------------
 *  ALL CUSTOM DATA
 *--------------------*/

#if LVGL_VERSION_MAJOR == 8
/*Store all the custom data of the font*/
static  lv_font_fmt_txt_glyph_cache_t cache;
#endif

#if LVGL_VERSION_MAJOR >= 8
static const lv_font_fmt_txt_dsc_t font_dsc = {
#else
static lv_font_fmt_txt_dsc_t font_dsc = {
#endif
    .glyph_bitmap = glyph_bitmap,
    .glyph_dsc = glyph_dsc,
    .cmaps = cmaps,
    .kern_dsc = NULL,
    .kern_scale = 0,
    .cmap_num = 1,
    .bpp = 4,
    .kern_classes = 0,
    .bitmap_format = 0,
#if LVGL_VERSION_MAJOR == 8
    .cache = &cache
#endif
};

extern const lv_font_t greek_alphabet_14;


/*-----------------
 *  PUBLIC FONT
 *----------------*/

/*Initialize a public general font descriptor*/
#if LVGL_VERSION_MAJOR >= 8
const lv_font_t Greek_alphabet_14 = {
#else
lv_font_t Greek_alphabet_14 = {
#endif
    .get_glyph_dsc = lv_font_get_glyph_dsc_fmt_txt,    /*Function pointer to get glyph's data*/
    .get_glyph_bitmap = lv_font_get_bitmap_fmt_txt,    /*Function pointer to get glyph's bitmap*/
    .line_height = 13,          /*The maximum line height required by the font*/
    .base_line = 3,             /*Baseline measured from the bottom of the line*/
#if !(LVGL_VERSION_MAJOR == 6 && LVGL_VERSION_MINOR == 0)
    .subpx = LV_FONT_SUBPX_NONE,
#endif
#if LV_VERSION_CHECK(7, 4, 0) || LVGL_VERSION_MAJOR >= 8
    .underline_position = -1,
    .underline_thickness = 1,
#endif
    .dsc = &font_dsc,          /*The custom font data. Will be accessed by `get_glyph_bitmap/dsc` */
#if LV_VERSION_CHECK(8, 2, 0) || LVGL_VERSION_MAJOR >= 9
    .fallback = &lv_font_montserrat_14,
#endif
    .user_data = NULL,
};



#endif /*#if GREEK_ALPHABET_14*/
