bjornpo/ESP32_SensorScope/(commit log)

2025-01-04 Add initial project structure and configuration for ESP32 SensorScope
2025-01-04 Added Digi-Key KiCad library as a submodule
2025-01-04 Added espressif kicad library
2025-01-04 initial commit of kicad and libraries
    [ESP32-S3-DevkitC-1.kicad_sch, ESP32-S3-WROOM-1.kicad_sch, ESP32_SensorScope.kicad_pcb, ESP32_SensorScope.kicad_sch]
2025-01-11 Added serial interfases
    [ESP32-S3-DevkitC-1.kicad_sch, ESP32-S3-WROOM-1.kicad_sch, ESP32_SensorScope.kicad_pcb, ESP32_SensorScope.kicad_sch, IO Extender.kicad_sch, Power_management.kicad_sch, RS232.kicad_sch, RS485.kicad_sch]
2025-01-19 Various changes
    [ESP32_SensorScope.kicad_sch, RS232.kicad_sch, RS485.kicad_sch, Scope.kicad_sch]
2025-01-19 Adde LCD Part
    [4Inch TFT SPI LCD 480X320.step, ESP32-S3-WROOM-1.kicad_sch, Scope.kicad_sch, UI.kicad_sch, current_voltage_loop.kicad_sch]
2025-01-20 updated 4-20mA interface
    [UI.kicad_sch, current_voltage_loop.kicad_sch]
2025-01-21 updated scope
    [Scope.kicad_sch]
2025-02-09 something probobly
    [ESP32-S3-WROOM-1.kicad_sch, Power_management.kicad_sch, RS232.kicad_sch, RS485.kicad_sch, Scope.kicad_sch, current_voltage_loop.kicad_sch]
2025-03-15 som updates on the schematics
    [ESP32-S3-WROOM-1.kicad_sch, IO Extender.kicad_sch, Power_management.kicad_sch, RS232.kicad_sch, RS485.kicad_sch, SDI12.kicad_sch, Scope.kicad_sch, UI.kicad_sch]
2025-03-16 updatet schematic
    [ESP32-S3-WROOM-1.kicad_sch, ESP32_SensorScope.kicad_sch, IO Extender.kicad_sch, Power_management.kicad_sch, RS232.kicad_sch, RS485.kicad_sch, Scope.kicad_sch, UART.kicad_sch]
2025-04-11 addet some footprints"
    [ESP32-S3-WROOM-1.kicad_sch, IO Extender.kicad_sch, Power_management.kicad_sch, RS232.kicad_sch, RS485.kicad_sch, SDI12.kicad_sch, Scope.kicad_sch, UART.kicad_sch]
2025-04-11 Changed folder-name from ESP32_SensorScope to ESP32_Sensorscope_PIO
